Perth-Artifactory/Vending-Machine/README.md

# Vending-Machine
Member can vending machine
