Perth-Artifactory/Vending-Machine/PCB Design/Vending_Machine.kicad_pcb

## KiCad design PCB Design/Vending_Machine.kicad_pcb (2024-05-20)

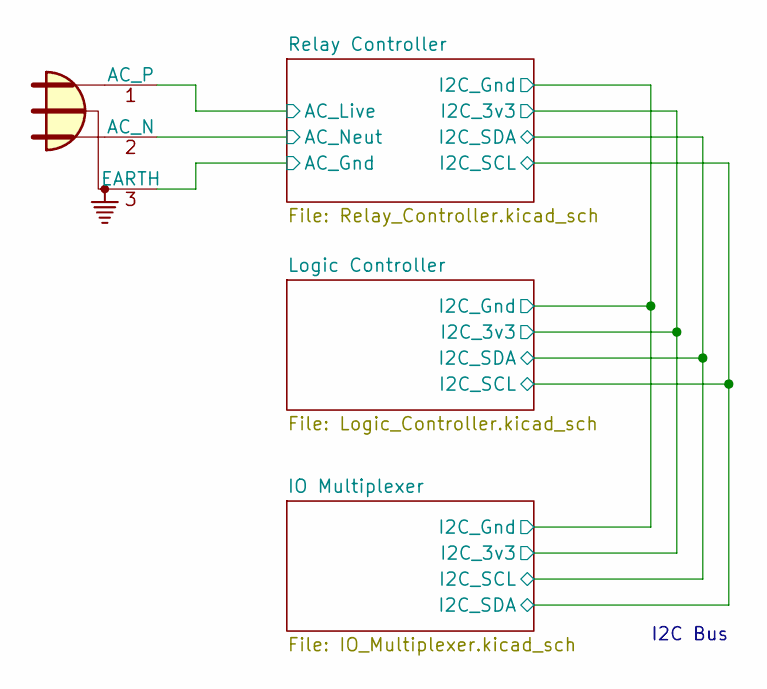
[picture p1: schematic Vending_Machine.kicad_sch, Vending Machine]

Parts:
P01: Main Supply

Notes on the sheet:
I2C Bus

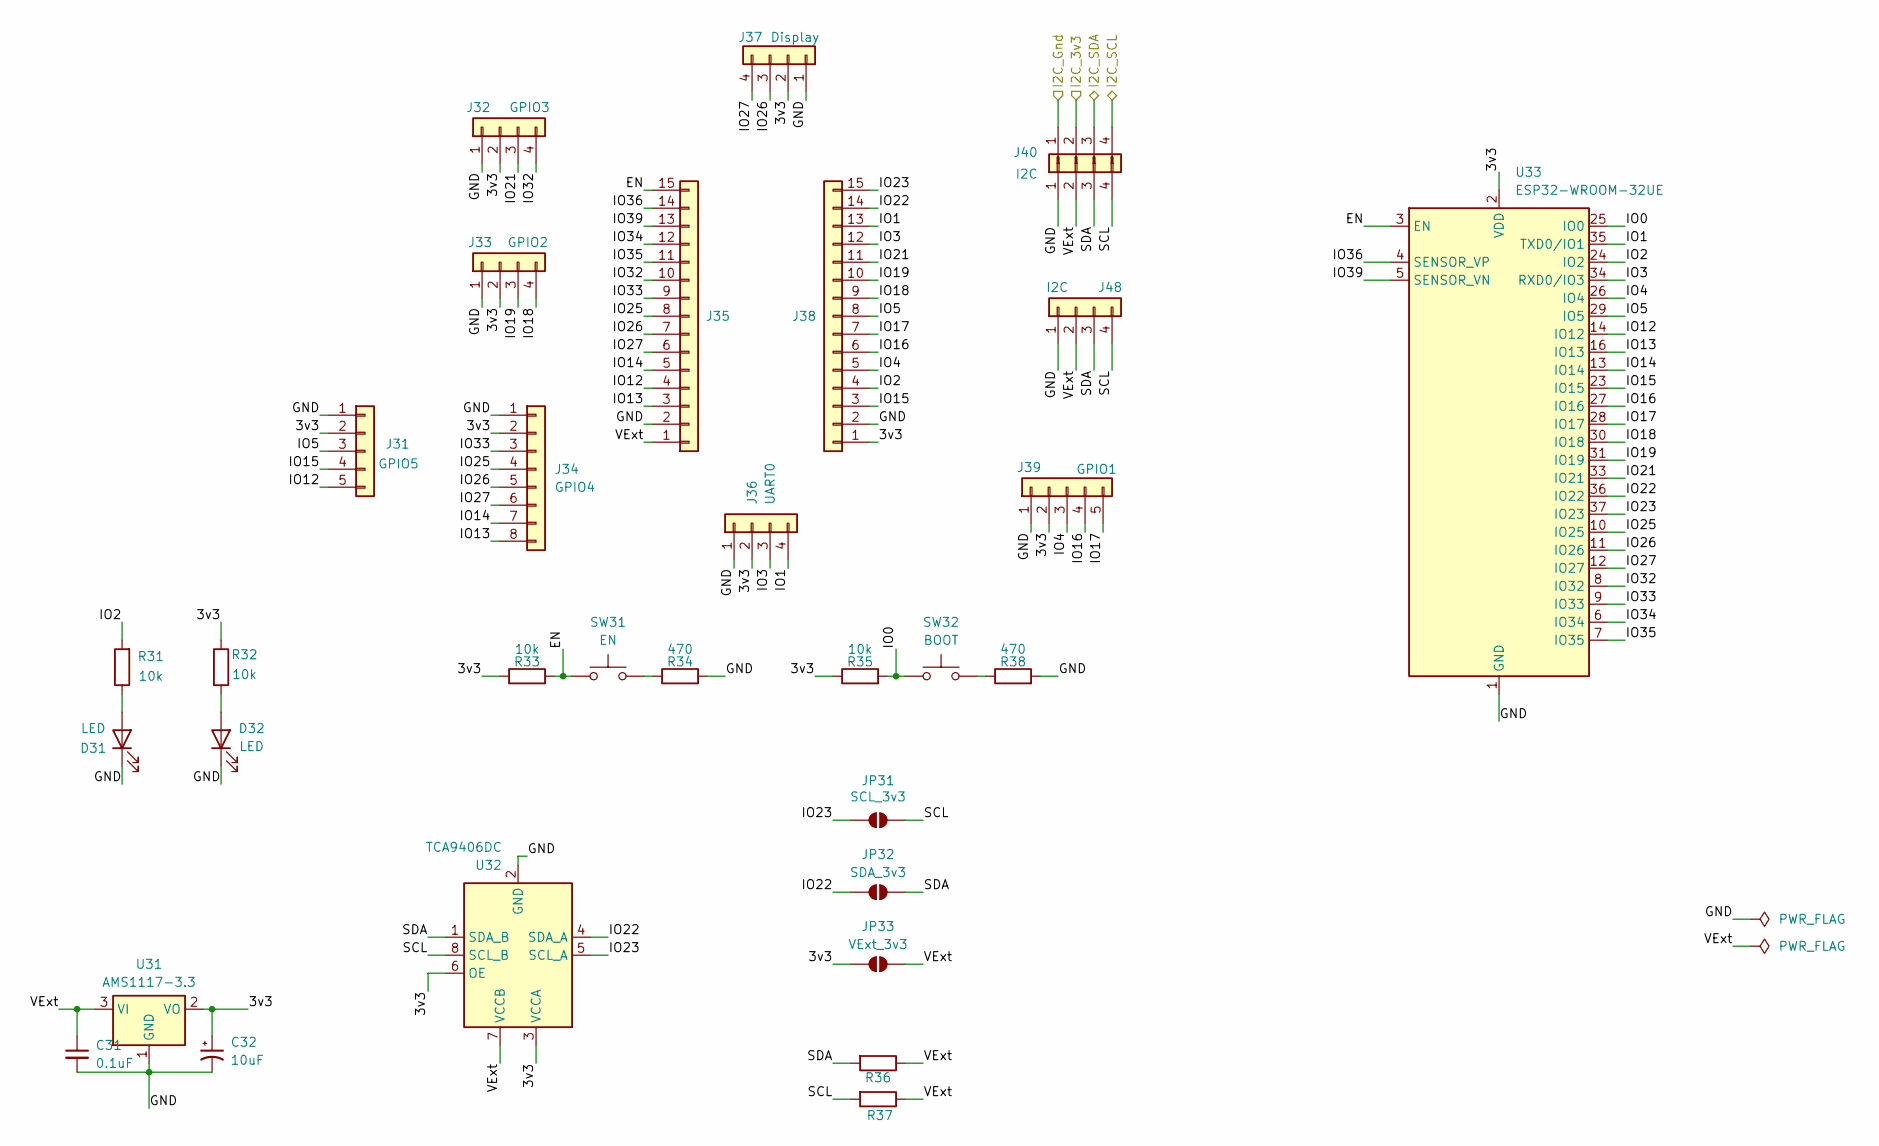
[picture p2: schematic Logic_Controller.kicad_sch, Logic Controller]

Parts:
C31: 0.1uF; C_0805_2012Metric_Pad1.18x1.45mm_HandSolder
C32: 10uF; C_0805_2012Metric_Pad1.18x1.45mm_HandSolder
D31, D32: LED; LED_0805_2012Metric_Pad1.15x1.40mm_HandSolder
J31: GPIO5; JST_XH_B5B-XH-A_1x05_P2.50mm_Vertical
J32: GPIO3; JST_XH_B4B-XH-A_1x04_P2.50mm_Vertical
J33: GPIO2; JST_XH_B4B-XH-A_1x04_P2.50mm_Vertical
J34: GPIO4; JST_XH_B8B-XH-A_1x08_P2.50mm_Vertical
J35, J38: Conn_01x15; PinHeader_1x15_P2.54mm_Vertical
J36: UART0; JST_XH_B4B-XH-A_1x04_P2.50mm_Vertical
J37: Display; PinHeader_1x04_P2.54mm_Vertical
J39: GPIO1; JST_XH_B5B-XH-A_1x05_P2.50mm_Vertical
J40, J48: I2C; JST_XH_B4B-XH-A_1x04_P2.50mm_Vertical
J44: Conn_01x04_Pin
JP31: SCL_3v3; SolderJumper-2_P1.3mm_Open_RoundedPad1.0x1.5mm
JP32: SDA_3v3; SolderJumper-2_P1.3mm_Open_RoundedPad1.0x1.5mm
JP33: VExt_3v3; SolderJumper-2_P1.3mm_Open_RoundedPad1.0x1.5mm
R31, R32, R33, R35: 10k; R_0805_2012Metric_Pad1.20x1.40mm_HandSolder
R34, R38: 470; R_0805_2012Metric_Pad1.20x1.40mm_HandSolder
R36, R37: R; R_0805_2012Metric_Pad1.20x1.40mm_HandSolder
SW31: EN; SW_Push_SPST_NO_Alps_SKRK
SW32: BOOT; SW_Push_SPST_NO_Alps_SKRK
U31: AMS1117-3.3; SOT-223-3_TabPin2
U32: TCA9406DC; VSSOP-8_2.3x2mm_P0.5mm
U33: ESP32-WROOM-32UE

Connections:
/Logic Controller/3v3: C32.1, J31.2, J32.2, J33.2, J34.2, J36.2, J37.2, J38.1, J39.2, JP33.1 (A), R32.1, R33.1, R35.1, U31.2 (VO), U32.3 (VCCA), U32.6 (OE), U33.2 (VDD)
/Logic Controller/EN: J35.15, R33.2, SW31.1, U33.3 (EN)
/Logic Controller/GND: C31.2, C32.2, D31.1 (K), D32.1 (K), J31.1, J32.1, J33.1, J34.1, J35.2, J36.1, J37.1, J38.2, J39.1, J40.1, J48.1, R34.2, R38.2, U31.1 (GND), U32.2 (GND), U33.1 (GND), U33.15 (GND), U33.38 (GND), U33.39 (GND); also elsewhere on the board
/Logic Controller/IO0: R35.2, SW32.1, U33.25 (IO0)
/Logic Controller/IO1: J36.4, J38.13, U33.35 (TXD0/IO1)
/Logic Controller/IO2: J38.4, R31.2, U33.24 (IO2)
/Logic Controller/IO3: J36.3, J38.12, U33.34 (RXD0/IO3)
/Logic Controller/IO4: J38.5, J39.3, U33.26 (IO4)
/Logic Controller/IO5: J31.3, J38.8, U33.29 (IO5)
/Logic Controller/IO12: J31.5, J35.4, U33.14 (IO12)
/Logic Controller/IO13: J34.8, J35.3, U33.16 (IO13)
/Logic Controller/IO14: J34.7, J35.5, U33.13 (IO14)
/Logic Controller/IO15: J31.4, J38.3, U33.23 (IO15)
/Logic Controller/IO16: J38.6, J39.4, U33.27 (IO16)
/Logic Controller/IO17: J38.7, J39.5, U33.28 (IO17)
/Logic Controller/IO18: J33.4, J38.9, U33.30 (IO18)
/Logic Controller/IO19: J33.3, J38.10, U33.31 (IO19)
/Logic Controller/IO21: J32.3, J38.11, U33.33 (IO21)
/Logic Controller/IO22: J38.14, JP32.1 (A), U32.4 (SDA_A), U33.36 (IO22)
/Logic Controller/IO23: J38.15, JP31.1 (A), U32.5 (SCL_A), U33.37 (IO23)
/Logic Controller/IO25: J34.4, J35.8, U33.10 (IO25)
/Logic Controller/IO26: J34.5, J35.7, J37.3, U33.11 (IO26)
/Logic Controller/IO27: J34.6, J35.6, J37.4, U33.12 (IO27)
/Logic Controller/IO32: J32.4, J35.10, U33.8 (IO32)
/Logic Controller/IO33: J34.3, J35.9, U33.9 (IO33)
/Logic Controller/IO34: J35.12, U33.6 (IO34)
/Logic Controller/IO35: J35.11, U33.7 (IO35)
/Logic Controller/IO36: J35.14, U33.4 (SENSOR_VP)
/Logic Controller/IO39: J35.13, U33.5 (SENSOR_VN)
/Logic Controller/SCL: J40.4, J48.4, JP31.2 (B), R37.2, U32.8 (SCL_B)
/Logic Controller/SDA: J40.3, J48.3, JP32.2 (B), R36.2, U32.1 (SDA_B)
/Logic Controller/VExt: C31.1, J35.1, J40.2, J48.2, JP33.2 (B), R36.1, R37.1, U31.3 (VI), U32.7 (VCCB)
unnamed: D31.2 (A), R31.1
unnamed: D32.2 (A), R32.2
unnamed: R34.1, SW31.2
unnamed: R38.1, SW32.2

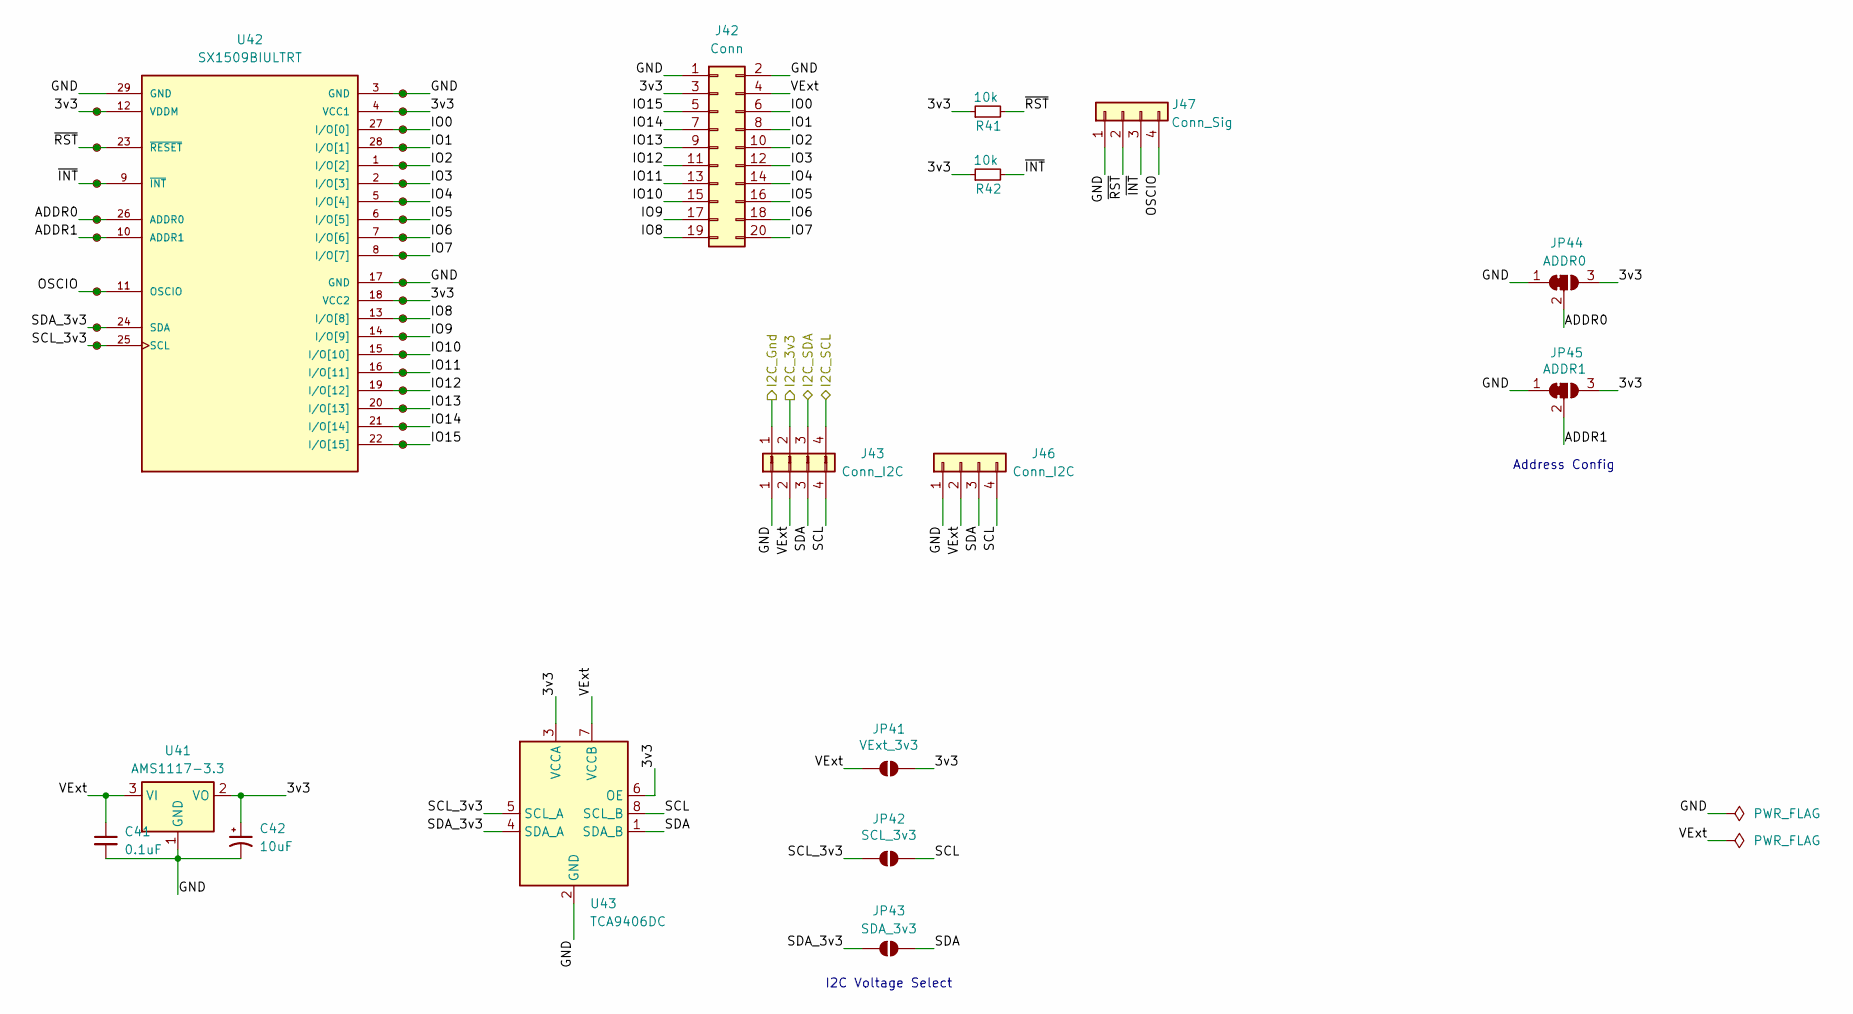
[picture p3: schematic IO_Multiplexer.kicad_sch, IO Multiplexer]

Parts:
C41: 0.1uF; C_0805_2012Metric_Pad1.18x1.45mm_HandSolder
C42: 10uF; C_0805_2012Metric_Pad1.18x1.45mm_HandSolder
J42: Conn; IDC-Header_2x10_P2.54mm_Vertical
J43, J46: Conn_I2C; JST_XH_B4B-XH-A_1x04_P2.50mm_Vertical
J45: Conn_01x04_Pin
J47: Conn_Sig; PinHeader_1x04_P2.54mm_Vertical
JP41: VExt_3v3; SolderJumper-2_P1.3mm_Open_RoundedPad1.0x1.5mm
JP42: SCL_3v3; SolderJumper-2_P1.3mm_Open_RoundedPad1.0x1.5mm
JP43: SDA_3v3; SolderJumper-2_P1.3mm_Open_RoundedPad1.0x1.5mm
JP44: ADDR0; SolderJumper-3_P1.3mm_Bridged12_RoundedPad1.0x1.5mm_NumberL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
JP45: ADDR1; SolderJumper-3_P1.3mm_Bridged12_RoundedPad1.0x1.5mm_NumberL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
R41, R42: 10k; R_0805_2012Metric_Pad1.20x1.40mm_HandSolder
TP39, TP48, TP58: 3v3; TestPoint_Pad_D1.0mm
TP40: ~{RST}; TestPoint_Pad_D1.0mm
TP41: ~{INT}; TestPoint_Pad_D1.0mm
TP42: Addr0; TestPoint_Pad_D1.0mm
TP43: Addr1; TestPoint_Pad_D1.0mm
TP44: OSC; TestPoint_Pad_D1.0mm
TP45: SDA; TestPoint_Pad_D1.0mm
TP46: SCL; TestPoint_Pad_D1.0mm
TP47, TP57: GND; TestPoint_Pad_D1.0mm
TP49: IO0; TestPoint_Pad_D1.0mm
TP50: IO1; TestPoint_Pad_D1.0mm
TP51: IO2; TestPoint_Pad_D1.0mm
TP52: IO3; TestPoint_Pad_D1.0mm
TP53: IO4; TestPoint_Pad_D1.0mm
TP54: IO5; TestPoint_Pad_D1.0mm
TP55: IO6; TestPoint_Pad_D1.0mm
TP56: IO7; TestPoint_Pad_D1.0mm
TP59: IO8; TestPoint_Pad_D1.0mm
TP60: IO9; TestPoint_Pad_D1.0mm
TP61: IO10; TestPoint_Pad_D1.0mm
TP62: IO11; TestPoint_Pad_D1.0mm
TP63: IO12; TestPoint_Pad_D1.0mm
TP64: IO13; TestPoint_Pad_D1.0mm
TP65: IO14; TestPoint_Pad_D1.0mm
TP66: IO15; TestPoint_Pad_D1.0mm
U41: AMS1117-3.3; SOT-223-3_TabPin2
U42: SX1509BIULTRT; QFN-28-1EP_4x4mm_P0.4mm_EP2.6x2.6mm_ThermalVias; PARTREV Rev 4 – 26th April 2011
U43: TCA9406DC; VSSOP-8_2.3x2mm_P0.5mm

Connections:
/IO Multiplexer/3v3: C42.1, J42.3, JP41.2 (B), JP44.3 (B), JP45.3 (B), R41.1, R42.1, TP39.1, TP48.1, TP58.1, U41.2 (VO), U42.4 (VCC1), U42.12 (VDDM), U42.18 (VCC2), U43.3 (VCCA), U43.6 (OE)
/IO Multiplexer/ADDR0: JP44.2 (C), TP42.1, U42.26 (ADDR0)
/IO Multiplexer/ADDR1: JP45.2 (C), TP43.1, U42.10 (ADDR1)
/IO Multiplexer/GND: C41.2, C42.2, J42.1, J42.2, J43.1, J46.1, J47.1, JP44.1 (A), JP45.1 (A), TP47.1, TP57.1, U41.1 (GND), U42.3 (GND), U42.17 (GND), U42.29 (GND), U43.2 (GND); also elsewhere on the board
/IO Multiplexer/IO0: J42.6, TP49.1, U42.27 (I/O[0])
/IO Multiplexer/IO1: J42.8, TP50.1, U42.28 (I/O[1])
/IO Multiplexer/IO2: J42.10, TP51.1, U42.1 (I/O[2])
/IO Multiplexer/IO3: J42.12, TP52.1, U42.2 (I/O[3])
/IO Multiplexer/IO4: J42.14, TP53.1, U42.5 (I/O[4])
/IO Multiplexer/IO5: J42.16, TP54.1, U42.6 (I/O[5])
/IO Multiplexer/IO6: J42.18, TP55.1, U42.7 (I/O[6])
/IO Multiplexer/IO7: J42.20, TP56.1, U42.8 (I/O[7])
/IO Multiplexer/IO8: J42.19, TP59.1, U42.13 (I/O[8])
/IO Multiplexer/IO9: J42.17, TP60.1, U42.14 (I/O[9])
/IO Multiplexer/IO10: J42.15, TP61.1, U42.15 (I/O[10])
/IO Multiplexer/IO11: J42.13, TP62.1, U42.16 (I/O[11])
/IO Multiplexer/IO12: J42.11, TP63.1, U42.19 (I/O[12])
/IO Multiplexer/IO13: J42.9, TP64.1, U42.20 (I/O[13])
/IO Multiplexer/IO14: J42.7, TP65.1, U42.21 (I/O[14])
/IO Multiplexer/IO15: J42.5, TP66.1, U42.22 (I/O[15])
/IO Multiplexer/OSCIO: J47.4, TP44.1, U42.11 (OSCIO)
/IO Multiplexer/SCL: J43.4, J46.4, JP42.2 (B), U43.8 (SCL_B)
/IO Multiplexer/SCL_3v3: JP42.1 (A), TP46.1, U42.25 (SCL), U43.5 (SCL_A)
/IO Multiplexer/SDA: J43.3, J46.3, JP43.2 (B), U43.1 (SDA_B)
/IO Multiplexer/SDA_3v3: JP43.1 (A), TP45.1, U42.24 (SDA), U43.4 (SDA_A)
/IO Multiplexer/VExt: C41.1, J42.4, J43.2, J46.2, JP41.1 (A), U41.3 (VI), U43.7 (VCCB)
/IO Multiplexer/~INT: J47.3, R42.2, TP41.1, U42.9 (~INT)
/IO Multiplexer/~RST: J47.2, R41.2, TP40.1, U42.23 (~RESET)

Notes on the sheet:
I2C Voltage Select
Address Config

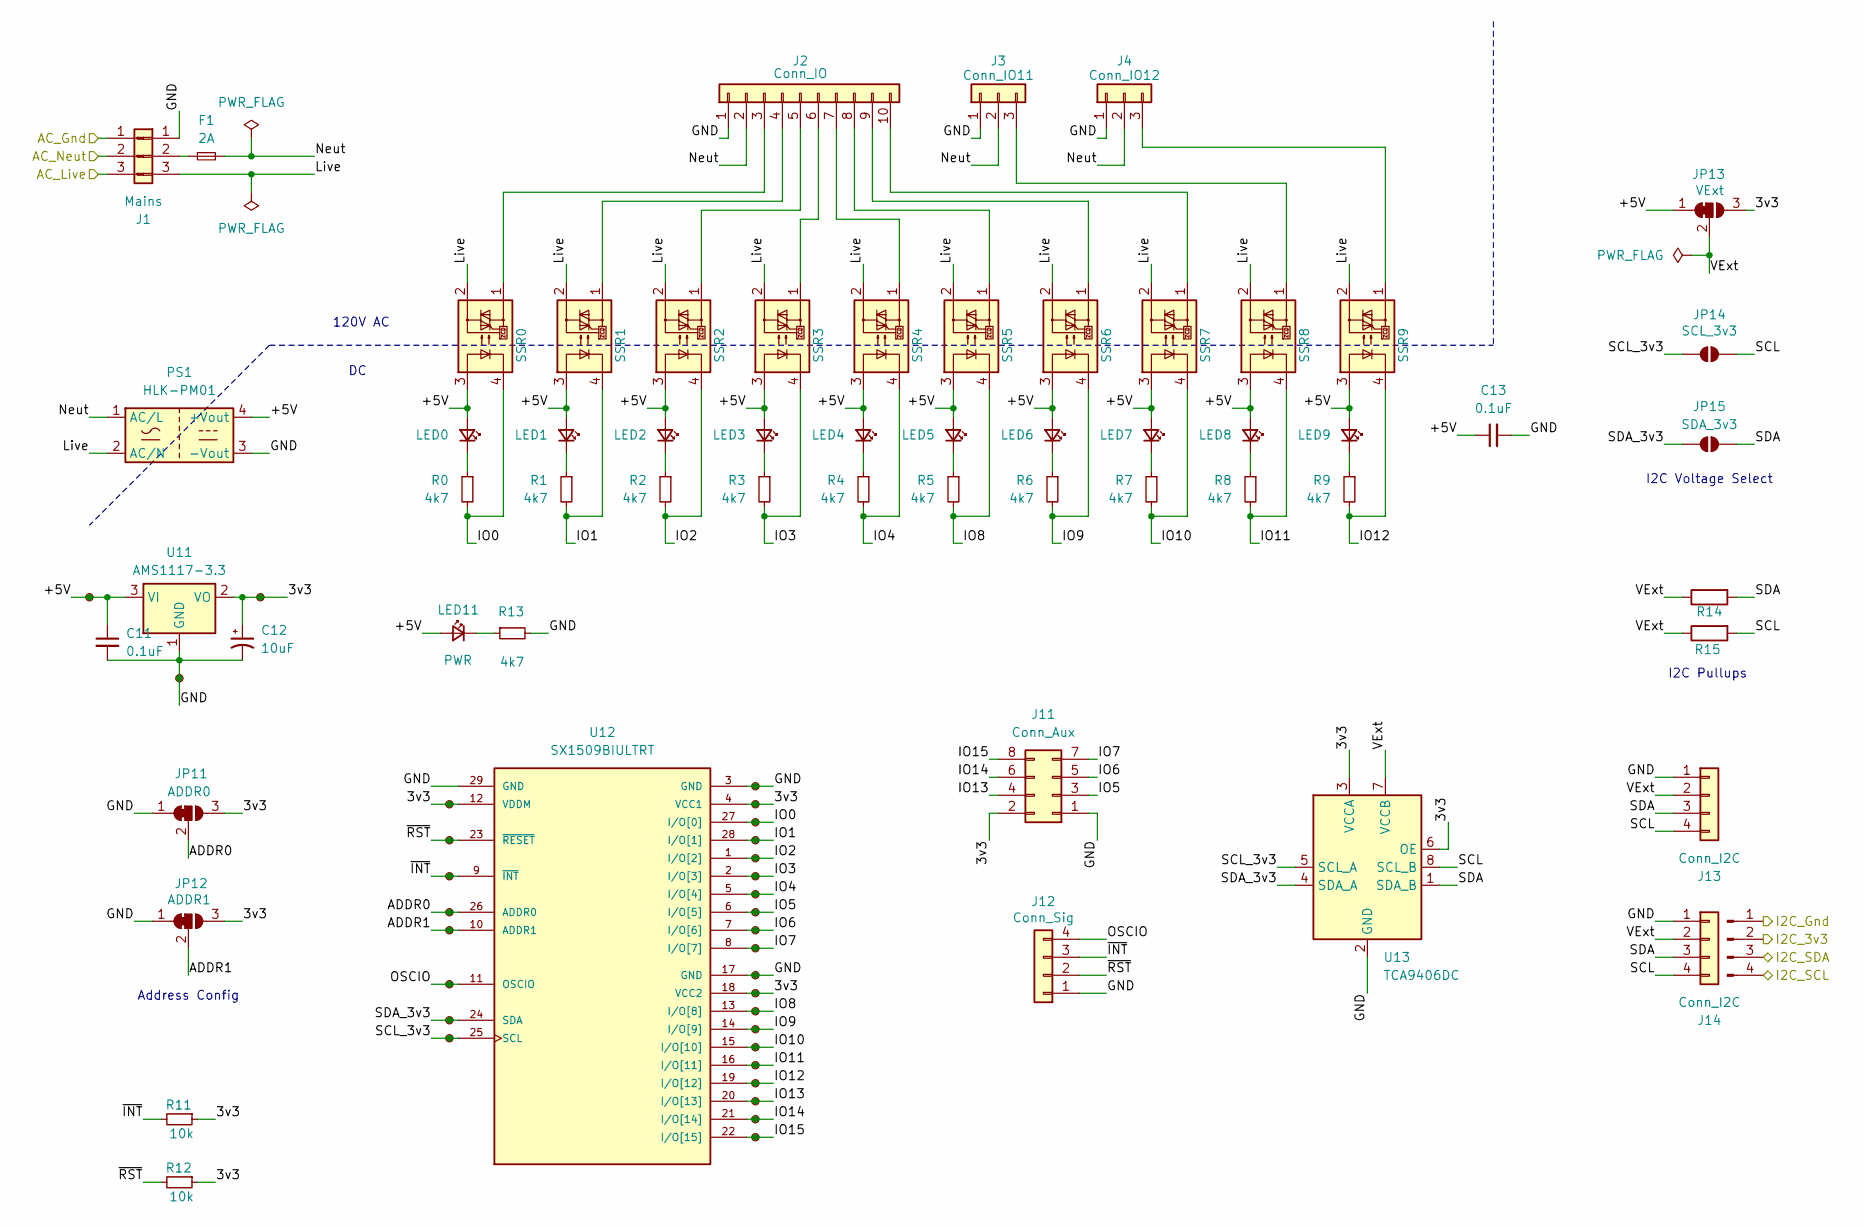
[picture p4: schematic Relay_Controller.kicad_sch, Relay Controller]

Parts:
C11, C13: 0.1uF; C_0805_2012Metric_Pad1.18x1.45mm_HandSolder
C12: 10uF; C_0805_2012Metric_Pad1.18x1.45mm_HandSolder
F1: 2A; Fuseholder_5x20mm_15mm_Pins
J1: Mains; PhoenixContact_MC_1,5_3-G-3.81_1x03_P3.81mm_Horizontal
J2: Conn_IO; PhoenixContact_MC_1,5_10-G-3.81_1x10_P3.81mm_Horizontal
J3: Conn_IO11; PhoenixContact_MC_1,5_3-G-3.81_1x03_P3.81mm_Horizontal
J4: Conn_IO12; PhoenixContact_MC_1,5_3-G-3.81_1x03_P3.81mm_Horizontal
J11: Conn_Aux; IDC-Header_2x04_P2.54mm_Vertical
J12: Conn_Sig; JST_XH_B4B-XH-A_1x04_P2.50mm_Vertical
J13, J14: Conn_I2C; JST_XH_B4B-XH-A_1x04_P2.50mm_Vertical
J15: Conn_01x04_Pin
J41: Conn_01x03_Pin
JP11: ADDR0; SolderJumper-3_P1.3mm_Bridged12_RoundedPad1.0x1.5mm_NumberL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
JP12: ADDR1; SolderJumper-3_P1.3mm_Bridged12_RoundedPad1.0x1.5mm_NumberL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
JP13: VExt; SolderJumper-3_P1.3mm_Bridged12_RoundedPad1.0x1.5mm_NumberL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
JP14: SCL_3v3; SolderJumper-2_P1.3mm_Open_RoundedPad1.0x1.5mm
JP15: SDA_3v3; SolderJumper-2_P1.3mm_Open_RoundedPad1.0x1.5mm
LED0, LED1, LED2, LED3, LED4, LED5, LED6, LED7, LED8, LED9: LED_Small; LED_0805_2012Metric_Pad1.15x1.40mm_HandSolder
LED11: PWR; LED_0805_2012Metric_Pad1.15x1.40mm_HandSolder
PS1: HLK-PM01; Converter_ACDC_Hi-Link_HLK-PMxx
R0, R1, R2, R3, R4, R5, R6, R7, R8, R9, R13: 4k7; R_0805_2012Metric_Pad1.20x1.40mm_HandSolder
R11, R12: 10k; R_0805_2012Metric_Pad1.20x1.40mm_HandSolder
R14, R15: R; R_0805_2012Metric_Pad1.20x1.40mm_HandSolder
SSR0, SSR1, SSR2, SSR3, SSR4, SSR5, SSR6, SSR7, SSR8, SSR9: 34.81-8240; RELAY_G3MB202PDC12
TP11: IO2; TestPoint_Pad_D1.0mm
TP12: IO3; TestPoint_Pad_D1.0mm
TP13, TP21, TP28, TP67: 3v3; TestPoint_Pad_D1.0mm
TP14, TP22, TP68: GND; TestPoint_Pad_D1.0mm
TP15: IO4; TestPoint_Pad_D1.0mm
TP16: IO5; TestPoint_Pad_D1.0mm
TP17: IO6; TestPoint_Pad_D1.0mm
TP18: IO7; TestPoint_Pad_D1.0mm
TP19: ~{INT}; TestPoint_Pad_D1.0mm
TP20: ~{RST}; TestPoint_Pad_D1.0mm
TP23: Addr0; TestPoint_Pad_D1.0mm
TP24: Addr1; TestPoint_Pad_D1.0mm
TP25: OSC; TestPoint_Pad_D1.0mm
TP26: SDA; TestPoint_Pad_D1.0mm
TP27: SCL; TestPoint_Pad_D1.0mm
TP29: IO8; TestPoint_Pad_D1.0mm
TP30: IO9; TestPoint_Pad_D1.0mm
TP31: IO10; TestPoint_Pad_D1.0mm
TP32: IO11; TestPoint_Pad_D1.0mm
TP33: IO12; TestPoint_Pad_D1.0mm
TP34: IO13; TestPoint_Pad_D1.0mm
TP35: IO14; TestPoint_Pad_D1.0mm
TP36: IO15; TestPoint_Pad_D1.0mm
TP37: IO0; TestPoint_Pad_D1.0mm
TP38: IO1; TestPoint_Pad_D1.0mm
TP69: 5V; TestPoint_Pad_D1.0mm
U11: AMS1117-3.3; SOT-223-3_TabPin2
U12: SX1509BIULTRT; QFN-28-1EP_4x4mm_P0.4mm_EP2.6x2.6mm_ThermalVias; PARTREV Rev 4 – 26th April 2011
U13: TCA9406DC; VSSOP-8_2.3x2mm_P0.5mm

Connections:
/Relay Controller/3v3: C12.1, J11.2, JP11.3 (B), JP12.3 (B), JP13.3 (B), R11.1, R12.1, TP13.1, TP21.1, TP28.1, TP67.1, U11.2 (VO), U12.4 (VCC1), U12.12 (VDDM), U12.18 (VCC2), U13.3 (VCCA), U13.6 (OE)
/Relay Controller/+5V: C11.1, C13.1, JP13.1 (A), LED0.2 (A), LED1.2 (A), LED2.2 (A), LED3.2 (A), LED4.2 (A), LED5.2 (A), LED6.2 (A), LED7.2 (A), LED8.2 (A), LED9.2 (A), LED11.2 (A), PS1.4 (+Vout), SSR0.3, SSR1.3, SSR2.3, SSR3.3, SSR4.3, SSR5.3, SSR6.3, SSR7.3, SSR8.3, SSR9.3, TP69.1, U11.3 (VI)
/Relay Controller/ADDR0: JP11.2 (C), TP23.1, U12.26 (ADDR0)
/Relay Controller/ADDR1: JP12.2 (C), TP24.1, U12.10 (ADDR1)
/Relay Controller/GND: C11.2, C12.2, C13.2, J1.1, J2.1, J3.1, J4.1, J11.1, J12.1, J13.1, J14.1, JP11.1 (A), JP12.1 (A), PS1.3 (-Vout), R13.2, TP14.1, TP22.1, TP68.1, U11.1 (GND), U12.3 (GND), U12.17 (GND), U12.29 (GND), U13.2 (GND); also elsewhere on the board
/Relay Controller/IO0: R0.2, SSR0.4, TP37.1, U12.27 (I/O[0])
/Relay Controller/IO1: R1.2, SSR1.4, TP38.1, U12.28 (I/O[1])
/Relay Controller/IO2: R2.2, SSR2.4, TP11.1, U12.1 (I/O[2])
/Relay Controller/IO3: R3.2, SSR3.4, TP12.1, U12.2 (I/O[3])
/Relay Controller/IO4: R4.2, SSR4.4, TP15.1, U12.5 (I/O[4])
/Relay Controller/IO5: J11.3, TP16.1, U12.6 (I/O[5])
/Relay Controller/IO6: J11.5, TP17.1, U12.7 (I/O[6])
/Relay Controller/IO7: J11.7, TP18.1, U12.8 (I/O[7])
/Relay Controller/IO8: R5.2, SSR5.4, TP29.1, U12.13 (I/O[8])
/Relay Controller/IO9: R6.2, SSR6.4, TP30.1, U12.14 (I/O[9])
/Relay Controller/IO10: R7.2, SSR7.4, TP31.1, U12.15 (I/O[10])
/Relay Controller/IO11: R8.2, SSR8.4, TP32.1, U12.16 (I/O[11])
/Relay Controller/IO12: R9.2, SSR9.4, TP33.1, U12.19 (I/O[12])
/Relay Controller/IO13: J11.4, TP34.1, U12.20 (I/O[13])
/Relay Controller/IO14: J11.6, TP35.1, U12.21 (I/O[14])
/Relay Controller/IO15: J11.8, TP36.1, U12.22 (I/O[15])
/Relay Controller/Live: J1.3, PS1.2 (AC/N), SSR0.2, SSR1.2, SSR2.2, SSR3.2, SSR4.2, SSR5.2, SSR6.2, SSR7.2, SSR8.2, SSR9.2
/Relay Controller/Neut: F1.2, J2.2, J3.2, J4.2, PS1.1 (AC/L)
/Relay Controller/OSCIO: J12.4, TP25.1, U12.11 (OSCIO)
/Relay Controller/SCL: J13.4, J14.4, JP14.2 (B), R15.2, U13.8 (SCL_B)
/Relay Controller/SCL_3v3: JP14.1 (A), TP27.1, U12.25 (SCL), U13.5 (SCL_A)
/Relay Controller/SDA: J13.3, J14.3, JP15.2 (B), R14.2, U13.1 (SDA_B)
/Relay Controller/SDA_3v3: JP15.1 (A), TP26.1, U12.24 (SDA), U13.4 (SDA_A)
/Relay Controller/VExt: J13.2, J14.2, JP13.2 (C), R14.1, R15.1, U13.7 (VCCB)
/Relay Controller/~INT: J12.3, R11.2, TP19.1, U12.9 (~INT)
/Relay Controller/~RST: J12.2, R12.2, TP20.1, U12.23 (~RESET)
unnamed: F1.1, J1.2
unnamed: J2.3, SSR0.1
unnamed: J2.4, SSR1.1
unnamed: J2.5, SSR2.1
unnamed: J2.6, SSR3.1
unnamed: J2.7, SSR4.1
unnamed: J2.8, SSR5.1
unnamed: J2.9, SSR6.1
unnamed: J2.10, SSR7.1
unnamed: J3.3, SSR8.1
unnamed: J4.3, SSR9.1
unnamed: LED0.1 (K), R0.1
unnamed: LED1.1 (K), R1.1
unnamed: LED2.1 (K), R2.1
unnamed: LED3.1 (K), R3.1
unnamed: LED4.1 (K), R4.1
unnamed: LED5.1 (K), R5.1
unnamed: LED6.1 (K), R6.1
unnamed: LED7.1 (K), R7.1
unnamed: LED8.1 (K), R8.1
unnamed: LED9.1 (K), R9.1
unnamed: LED11.1 (K), R13.1

Notes on the sheet:
120V AC
I2C Pullups
Address Config
I2C Voltage Select

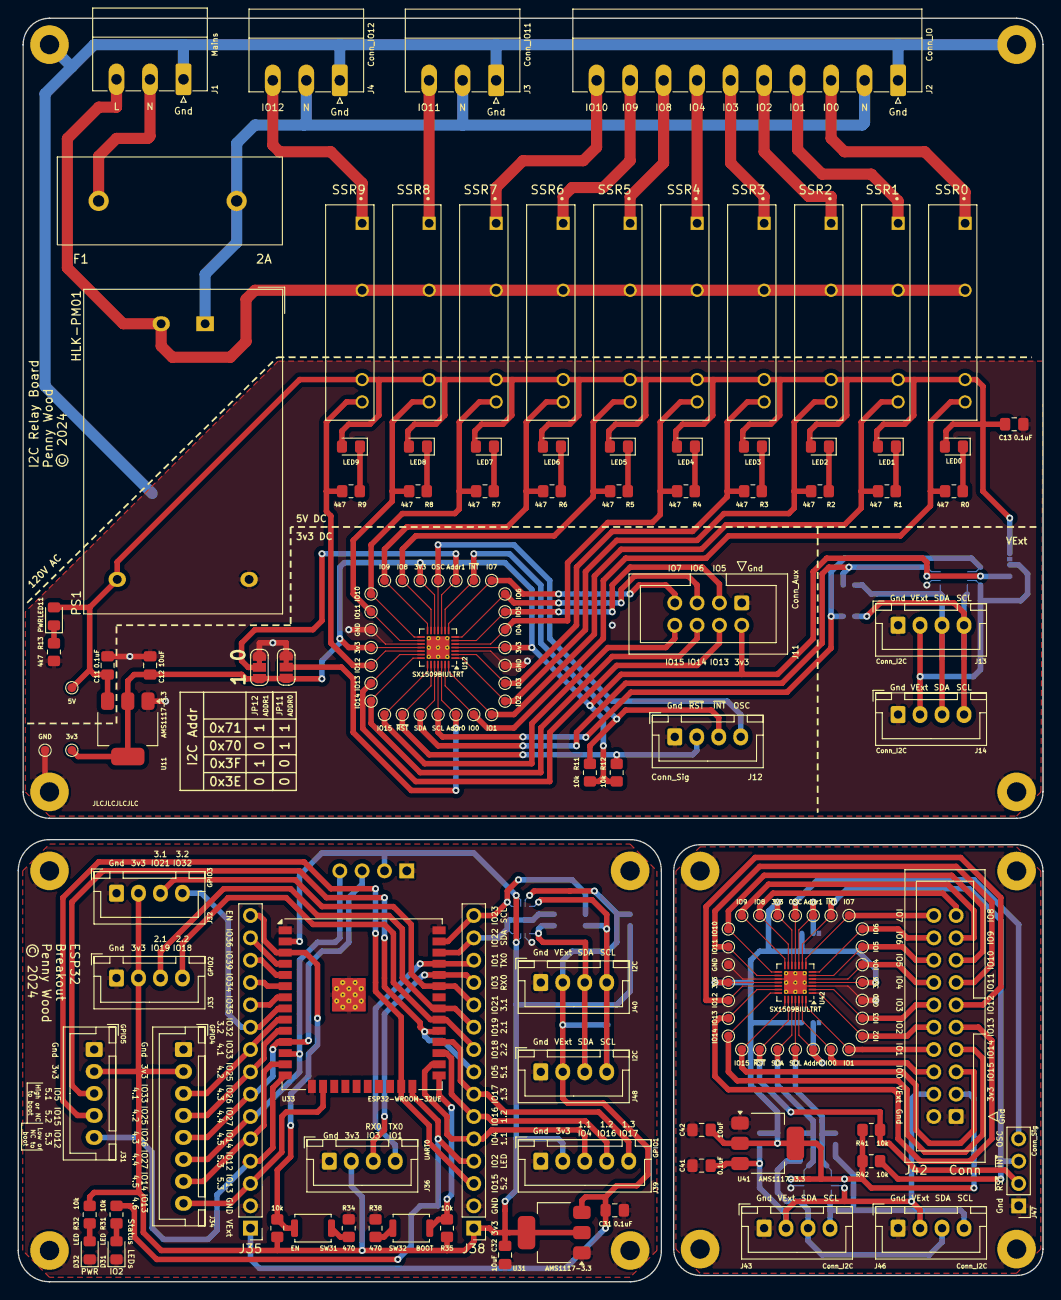
[picture p5: board Vending_Machine.kicad_pcb from above]

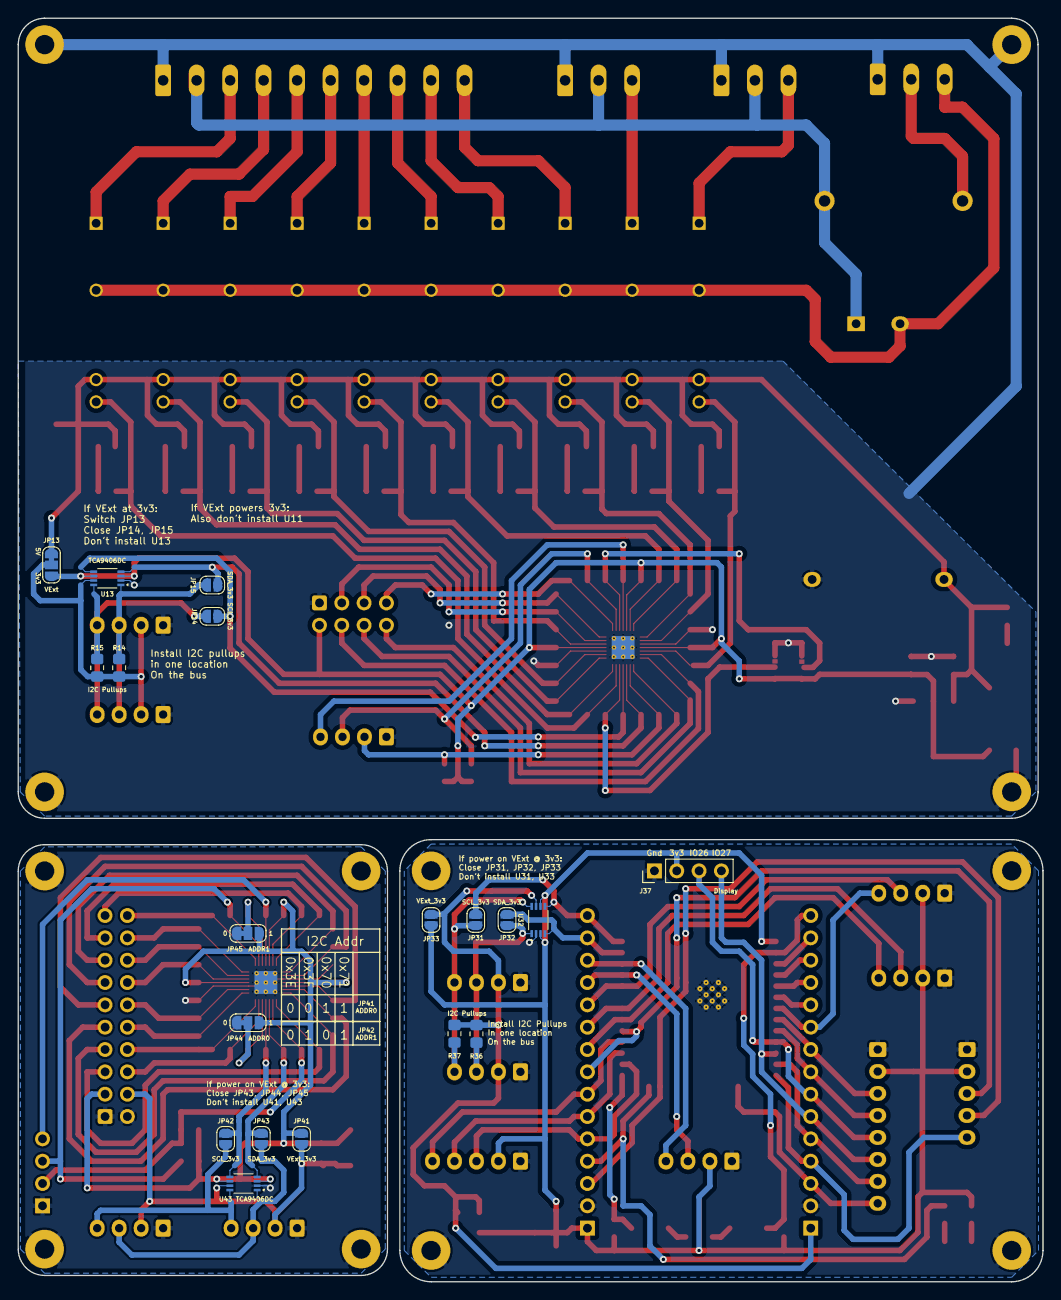
[picture p6: board Vending_Machine.kicad_pcb from below]

Board: 2 copper layers, 116.6 x 143.7 mm, 178 parts (19 on the bottom side), 117 nets.

Other parts of the board:
B1: Relay; Board
B2: Controller; Board
B3: Multiplexer; Board
H1, H2, H3, H4, H31, H32, H33, H34, H41, H42, H43, H44: MountingHole_2.2mm_M2_Pad

Their connections:
/IO Multiplexer/GND: H41.1, H42.1, H43.1, H44.1; also elsewhere on the board
/Logic Controller/GND: H31.1, H32.1, H33.1, H34.1; also elsewhere on the board
/Relay Controller/GND: H1.1, H2.1, H3.1, H4.1; also elsewhere on the board
