Perth-Artifactory/Vending-Machine/(commit log)

2024-03-29 Controller Board
    Sub board for the controller
    [Logic_Controller.kicad_sch, Relay_Controller.kicad_sch, Vending Machine.kicad_pcb, Vending Machine.kicad_sch, Vending_Machine.kicad_pcb, Vending_Machine.kicad_sch]
2024-03-29 Minor Tweaks
    [Vending_Machine.kicad_pcb]
2024-03-30 Added Multiplexer
    Added separate IO Multiplexer breakout
    [IO_Multiplexer.kicad_sch, Logic_Controller.kicad_sch, Relay_Controller.kicad_sch, Vending_Machine.kicad_pcb, Vending_Machine.kicad_sch]
2024-03-30 Minor Improvements
    [IO_Multiplexer.kicad_sch, Vending_Machine.kicad_pcb, Vending_Machine.kicad_sch]
2024-03-31 Tweaks and Updates
    Added OSCIO pin to breakout board.
    A few more tweaks
    [IO_Multiplexer.kicad_sch, Logic_Controller.kicad_sch, Relay_Controller.kicad_sch, Vending_Machine.kicad_pcb]
2024-04-04 Add OSCIO pin and voltage section silk-screen
    [Relay_Controller.kicad_sch, Vending_Machine.kicad_pcb]
2024-04-04 Add PCB design documentation
2024-04-15 Testpoints to schematic.
    [IO_Multiplexer.kicad_sch, Logic_Controller.kicad_sch, Relay_Controller.kicad_sch, Vending_Machine.kicad_pcb]
2024-04-24 Vcc->3v3 Added extra GPIO
    [IO_Multiplexer.kicad_sch, Logic_Controller.kicad_sch, Relay_Controller.kicad_sch, Vending_Machine.kicad_pcb, Vending_Machine.kicad_sch]
2024-05-06 Ready for production
    Moved connectors to slightly overlap board edge
    [IO_Multiplexer.kicad_sch, Vending_Machine.kicad_pcb]
2024-05-08 Fix layer error
    [Vending_Machine.kicad_pcb]
2024-05-20 Fixed silk screens
    Silk screen had incorrect numbering for some pins.
    [Vending_Machine.kicad_pcb]
