Perth-Artifactory/Vending-Machine/(notices)

Notices in the files:
PCB Design/Vending_Machine.kicad_pcb:
© 2024
